ashvnv/PIC16F-Internet-Clock/Datasheets/AMS1117 Module Schematic.png

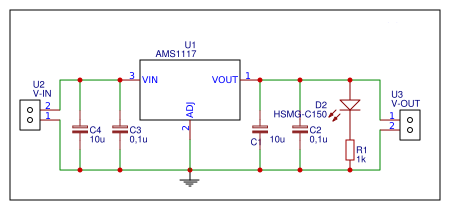
Datasheets/AMS1117 Module Schematic.png
