ashvnv/PIC16F-Internet-Clock/Datasheets/ds1307 hw111.jpg

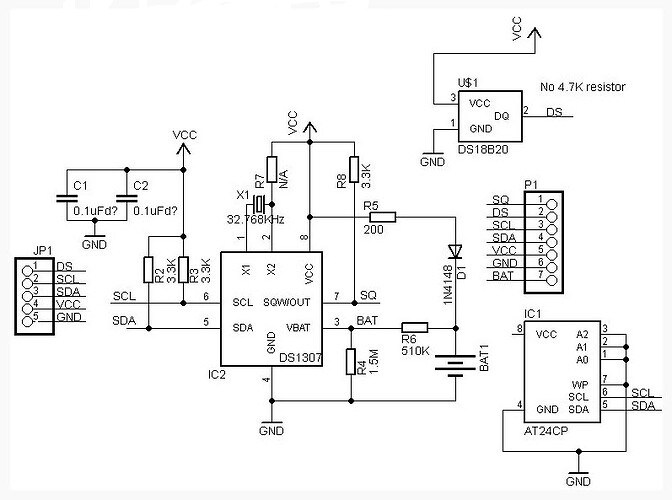
Datasheets/ds1307 hw111.jpg
