ashvnv/PIC16F-Internet-Clock/Images/Full Circuit (Proteus).png

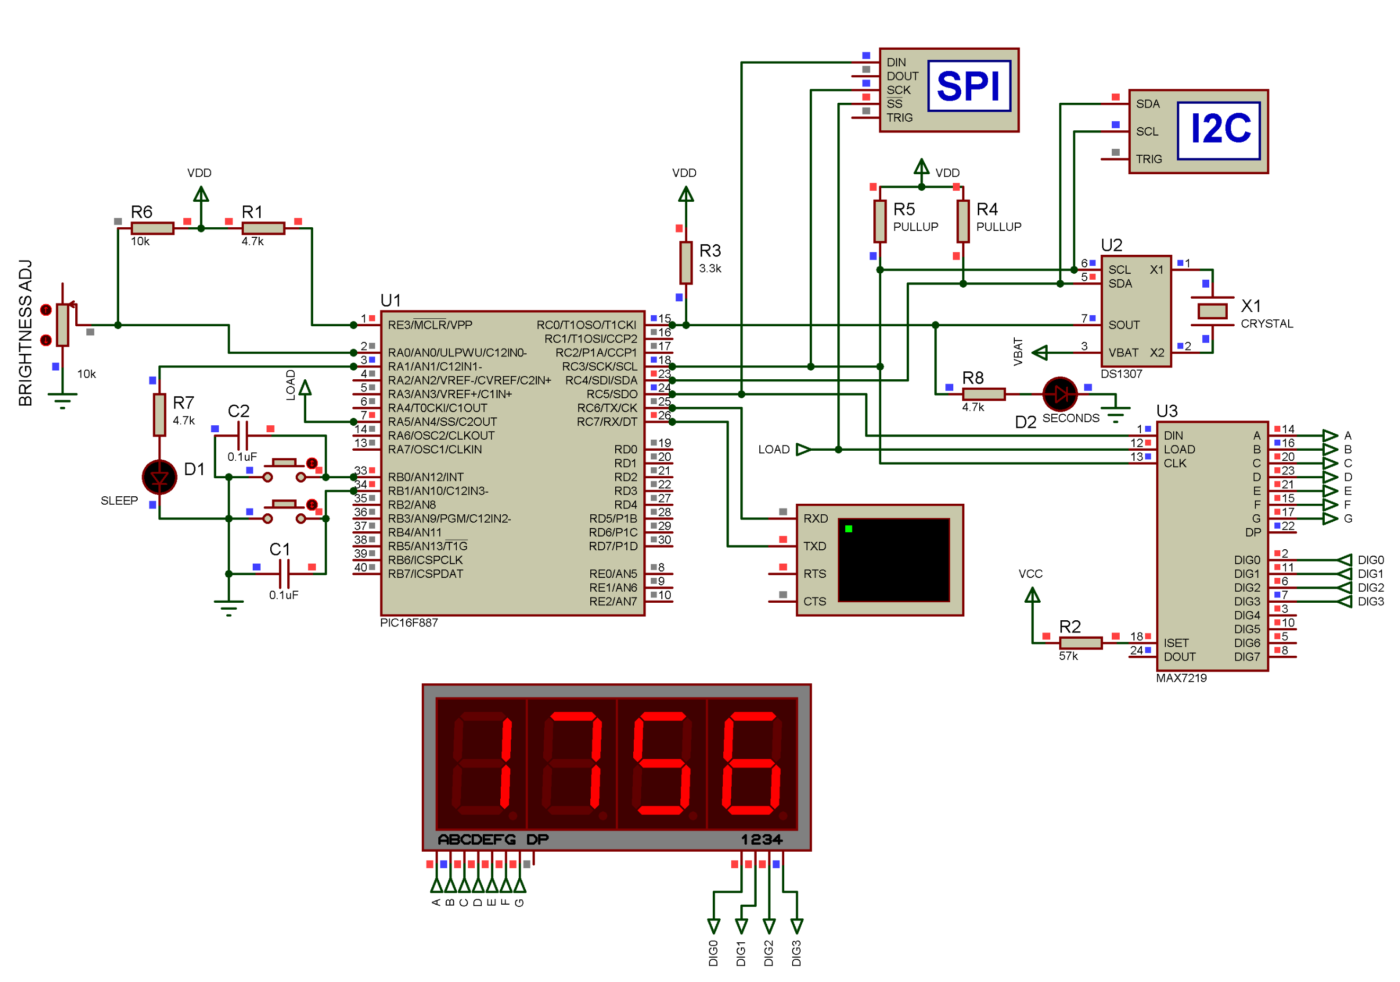
Images/Full Circuit (Proteus).png
