ashvnv/PIC16F-Internet-Clock/Images/Internet Clock 2.jpg

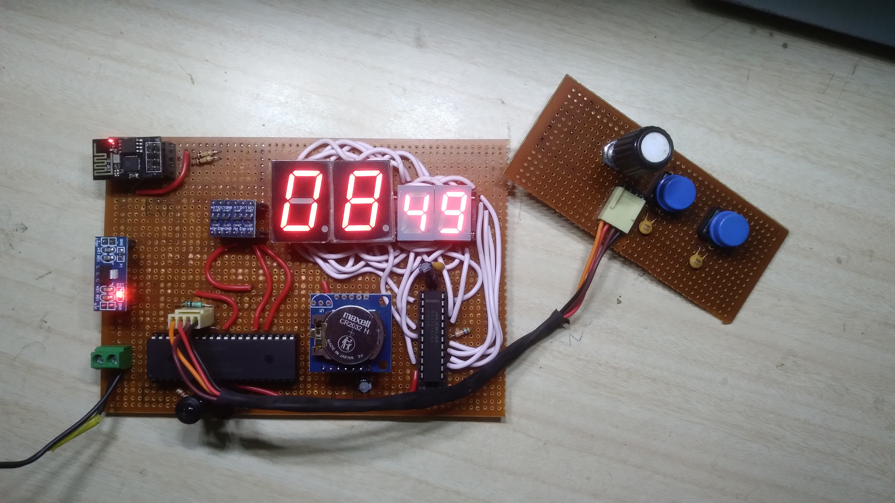
Images/Internet Clock 2.jpg
