ashvnv/PIC16F-Internet-Clock/Images/Labelled.png

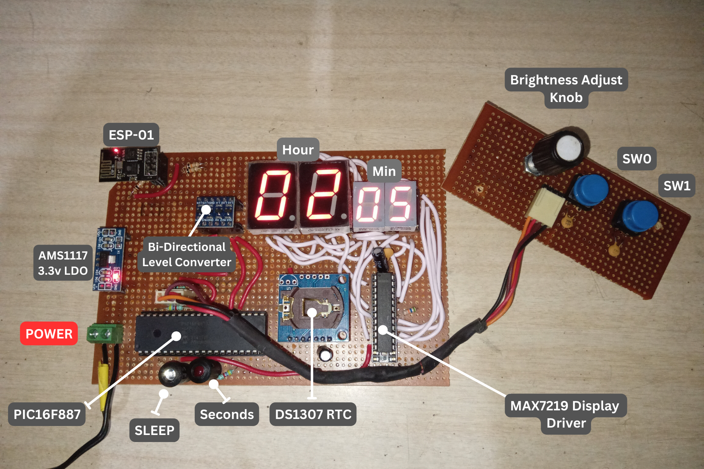
Images/Labelled.png
