ashvnv/PIC16F-Internet-Clock/(list of files, drawings)

Other design files:
FINAL SIMULATION (OVERALL)/New Project.pdsprj
