ashvnv/PIC16F-Internet-Clock/(notices)

Notices in the files:
README.md:
MIT License
